N3MI-DG/sc-guides/A4T/README.md

# DragonBurner for StealthChanger

Goto [stealthchanger.com](https://www.stealthchanger.com/hardware/guides/toolheads/4_a4t/) for the build guide.

This collection is just for archive purposes.
Credits to Armchair-Heavy-Industries for the [A4T](https://github.com/Armchair-Heavy-Industries/A4T) and DraftShift Design for [StealthChanger](https://github.com/DraftShift/StealthChanger).
