N3MI-DG/sc-guides/Yavoth/README.md

# Yavoth HF for StealthChanger

Goto [stealthchanger.com](https://www.stealthchanger.com/hardware/guides/toolheads/3_yavoth/) for the build guide.

This collection is just for archive purposes.
Credits to chirpy2605 for the [Yavoth](https://github.com/chirpy2605/voron/tree/main/V0/Yavoth) and DraftShift Design for [StealthChanger](https://github.com/DraftShift/StealthChanger).
