N3MI-DG/sc-guides/DragonBurner/README.md

# DragonBurner for StealthChanger

Goto [stealthchanger.com](https://www.stealthchanger.com/hardware/guides/toolheads/2_dragonburner/) for the build guide.

This collection is just for archive purposes.
Credits to chirpy2605 for the [DragonBurner](https://github.com/chirpy2605/voron/tree/main/V0/Dragon_Burner) and DraftShift Design for [StealthChanger](https://github.com/DraftShift/StealthChanger).
