N3MI-DG/sc-guides/Anthead/images/nh36-revc-pinout-20250331.jpg

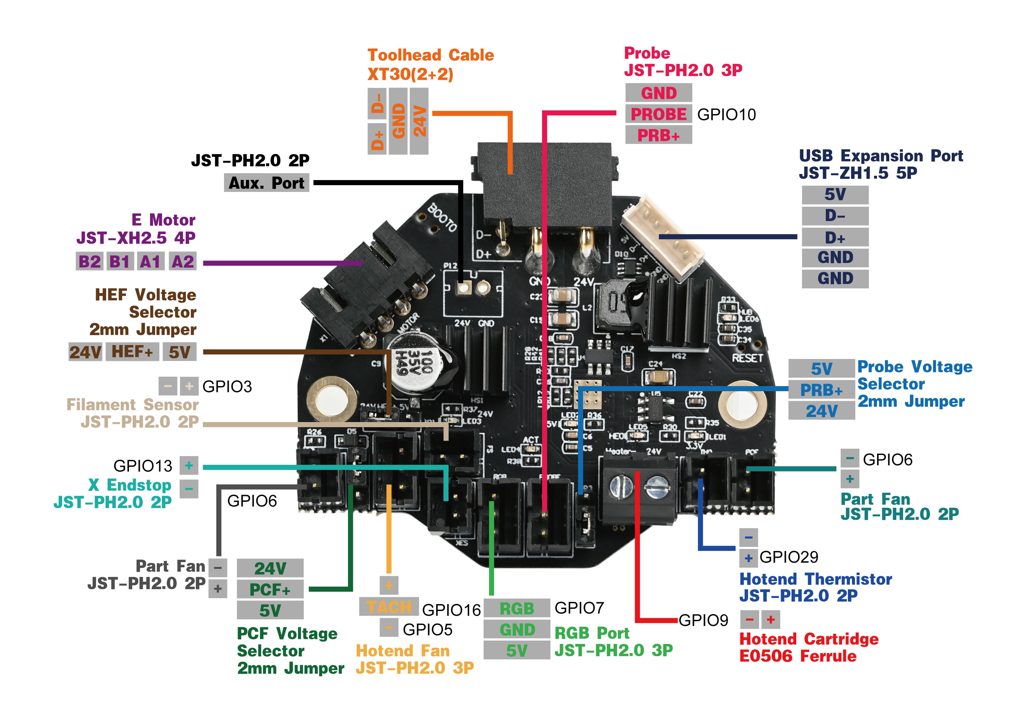
Anthead/images/nh36-revc-pinout-20250331.jpg
