N3MI-DG/sc-guides/Anthead/STL/SF O2 Main Body.stl

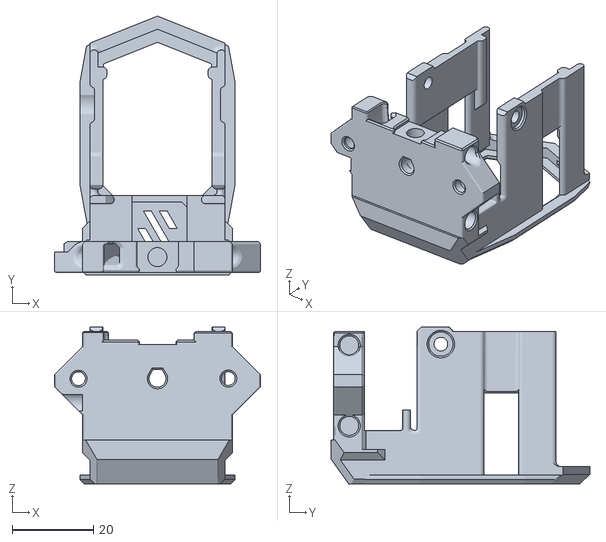
[picture p33: CAD file, 2025-06-15]
Anthead/STL/SF O2 Main Body.stl
50.8 x 63.8 x 38.6
