N3MI-DG/sc-guides/A4T/STL/A4T LED Carrier.stl

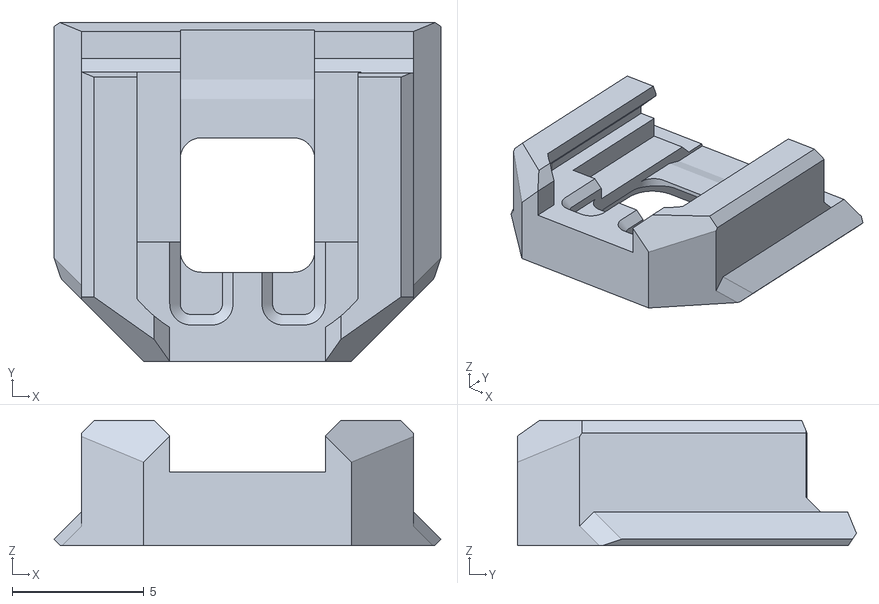
[picture p34: CAD file, 2026-03-08]
A4T/STL/A4T LED Carrier.stl
14.7 x 12.9 x 4.75
