N3MI-DG/sc-guides/Anthead/STL/[a] Revo HE Mount.stl

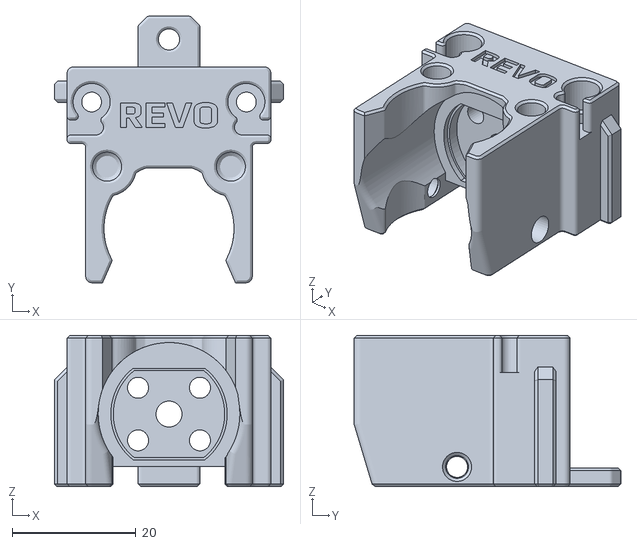
[picture p35: CAD file, 2026-01-17]
Anthead/STL/[a] Revo HE Mount.stl
37.0 x 43.1 x 24.4
