N3MI-DG/sc-guides/DragonBurner/STL/Solder Jig.stl

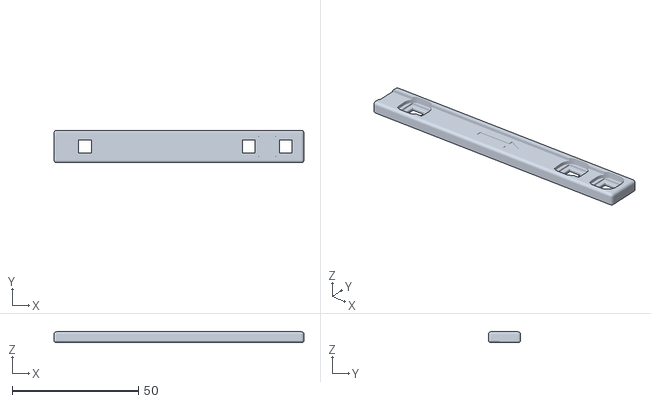
[picture p36: CAD file, 2026-01-14]
DragonBurner/STL/Solder Jig.stl
99.2 x 12.8 x 4.18
