N3MI-DG/sc-guides/Yavoth/STL/EBB Mount.stl

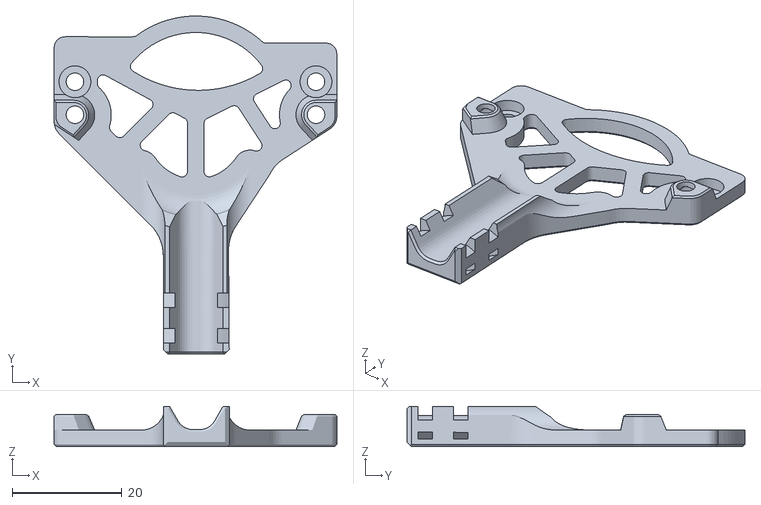
[picture p37: CAD file, 2025-12-29]
Yavoth/STL/EBB Mount.stl
51.4 x 61.5 x 7.30
