N3MI-DG/sc-guides/A4T/STL/A4T LED Filter[opaque].stl

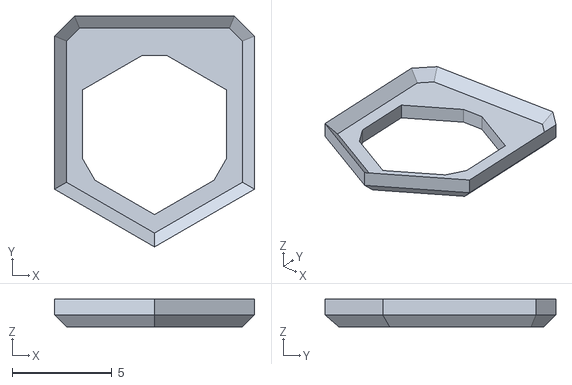
[picture p38: CAD file, 2026-03-08]
A4T/STL/A4T LED Filter[opaque].stl
10.0 x 11.5 x 1.40
