N3MI-DG/sc-guides/Anthead/STL/[c] Diffuser Voron.stl

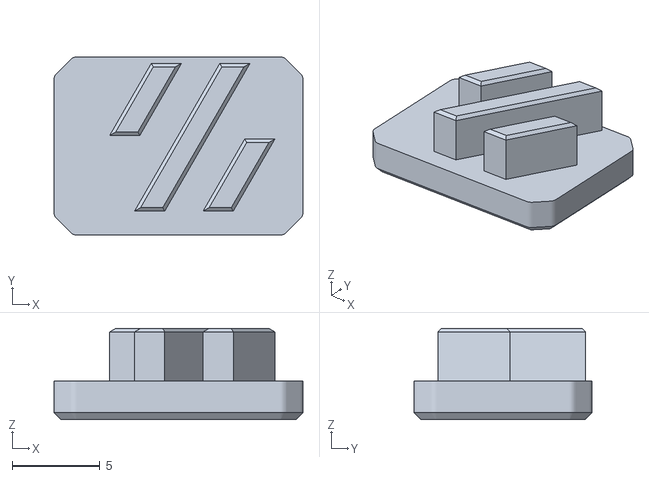
[picture p39: CAD file, 2025-06-15]
Anthead/STL/[c] Diffuser Voron.stl
14.2 x 10.1 x 5.20
