N3MI-DG/sc-guides/DragonBurner/STL/Neopixel Carrier.stl

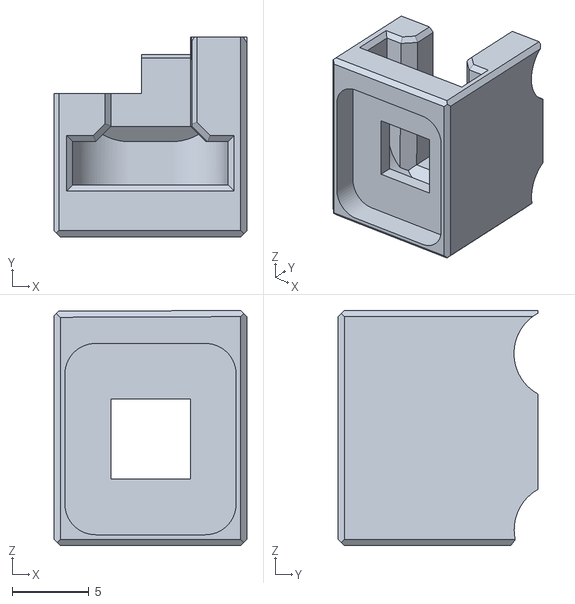
[picture p40: CAD file, 2025-12-28]
DragonBurner/STL/Neopixel Carrier.stl
12.5 x 13.0 x 15.3
