N3MI-DG/sc-guides/Yavoth/STL/Yavoth Backplate.stl

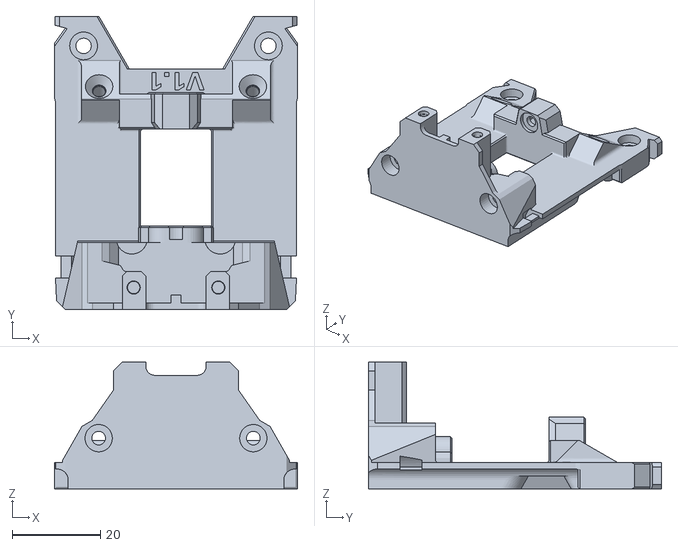
[picture p41: CAD file, 2025-12-29]
Yavoth/STL/Yavoth Backplate.stl
55.0 x 66.3 x 28.7
