N3MI-DG/sc-guides/A4T/STL/A4T - THB Mount - WWBMG.stl

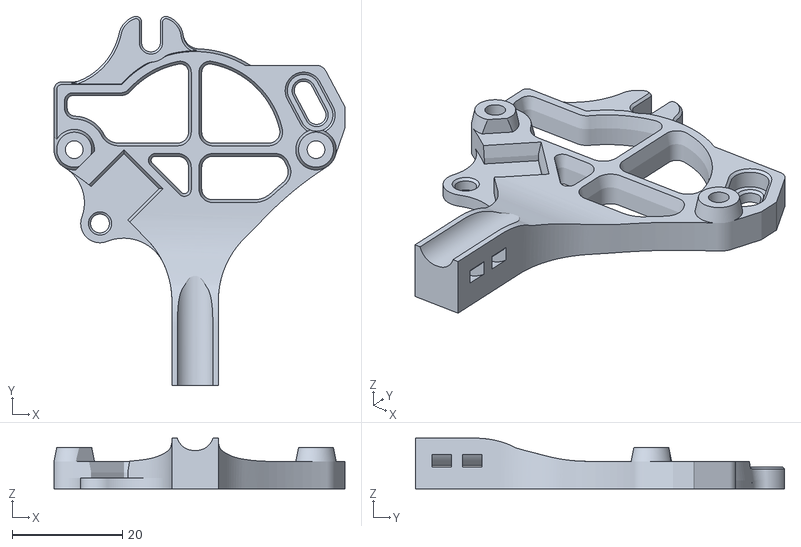
[picture p42: CAD file, 2026-03-08]
A4T/STL/A4T - THB Mount - WWBMG.stl
52.8 x 67.0 x 9.20
