N3MI-DG/sc-guides/Anthead/STL/[a] Right Duct Standard.stl

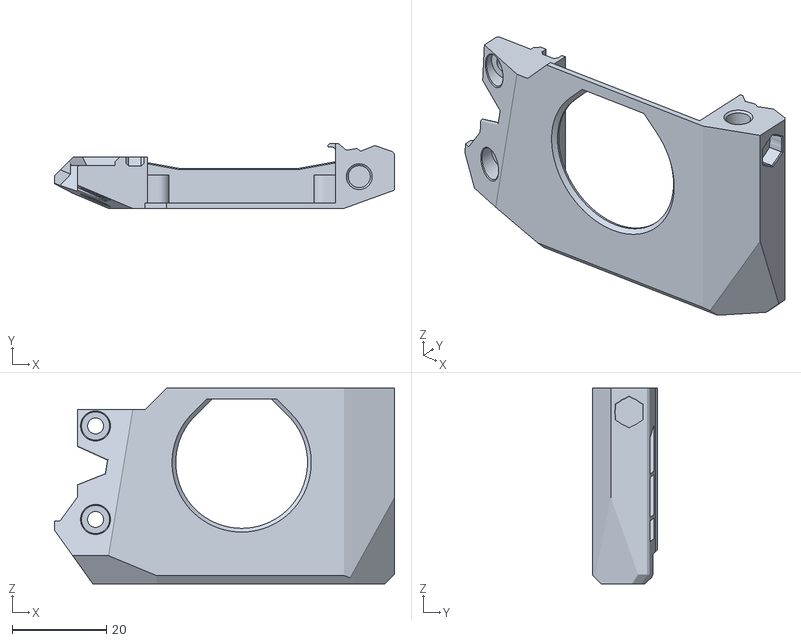
[picture p43: CAD file, 2025-06-15]
Anthead/STL/[a] Right Duct Standard.stl
72.3 x 13.8 x 41.6
