N3MI-DG/sc-guides/DragonBurner/STL/EBB Mount.stl

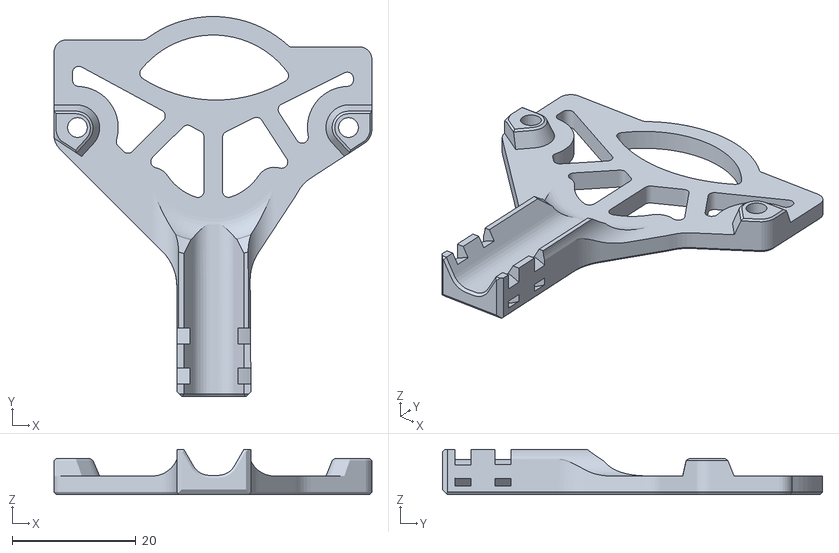
[picture p44: CAD file, 2025-12-28]
DragonBurner/STL/EBB Mount.stl
51.4 x 61.5 x 7.30
