N3MI-DG/sc-guides/Yavoth/STL/LED Holder.stl

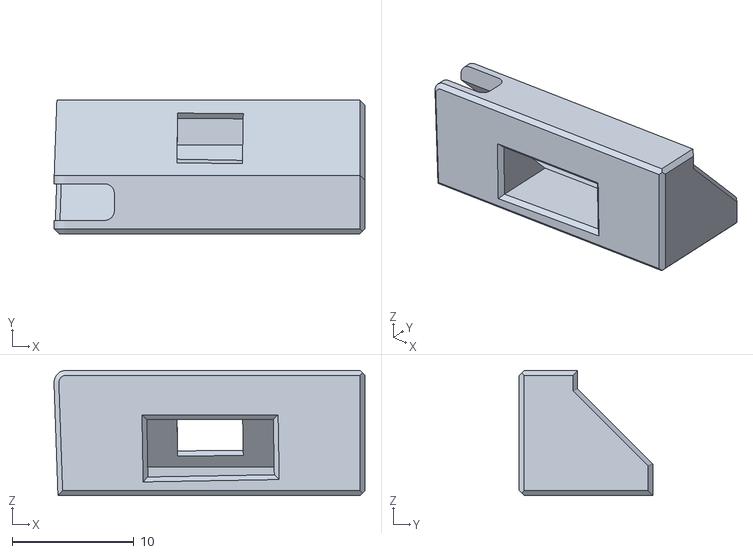
[picture p45: CAD file, 2025-12-29]
Yavoth/STL/LED Holder.stl
25.6 x 11.0 x 10.3
