N3MI-DG/sc-guides/A4T/STL/A4T Backflow Inhibitor install spacer tool.stl

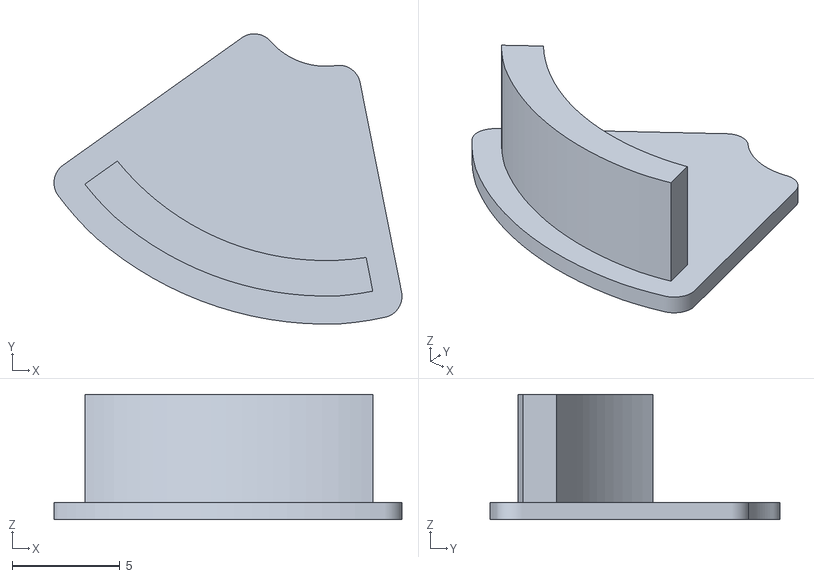
[picture p46: CAD file, 2026-03-08]
A4T/STL/A4T Backflow Inhibitor install spacer tool.stl
16.1 x 13.4 x 5.80
