N3MI-DG/sc-guides/DragonBurner/STL/Sherpa Mini Mount.stl

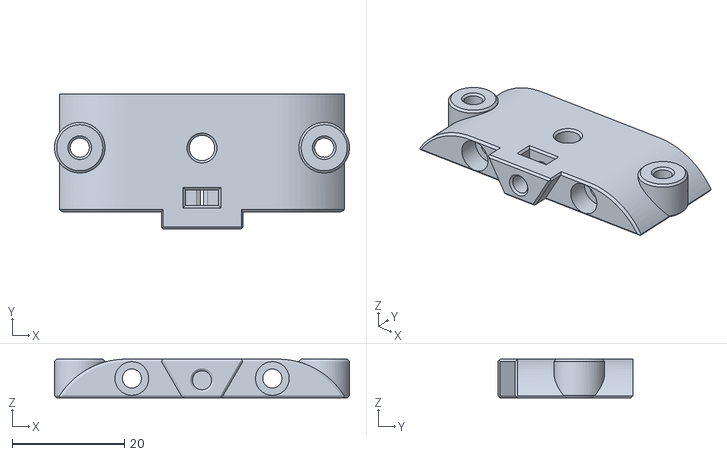
[picture p47: CAD file, 2025-12-28]
DragonBurner/STL/Sherpa Mini Mount.stl
52.5 x 24.1 x 6.90
