N3MI-DG/sc-guides/Yavoth/STL/Yavoth Cowl.stl

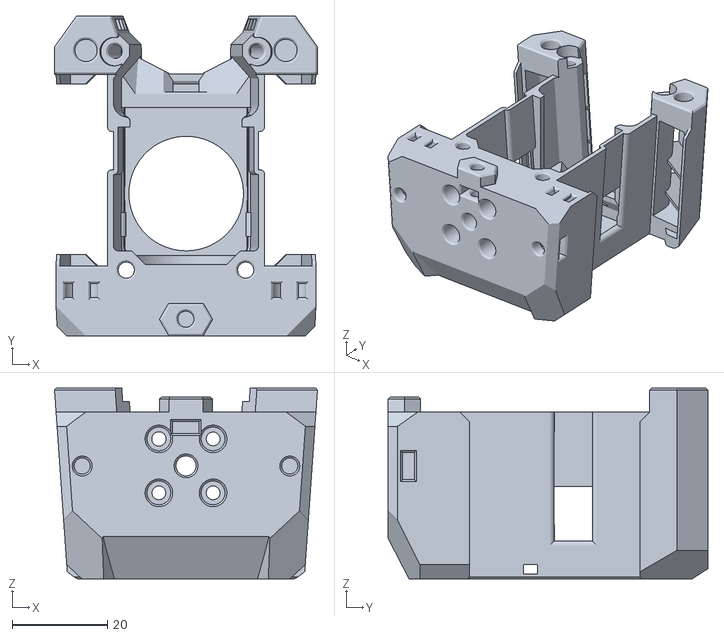
[picture p48: CAD file, 2025-12-29]
Yavoth/STL/Yavoth Cowl.stl
55.1 x 67.0 x 40.0
