N3MI-DG/sc-guides/A4T/STL/A4T HE Fan Duct - Rapido.stl

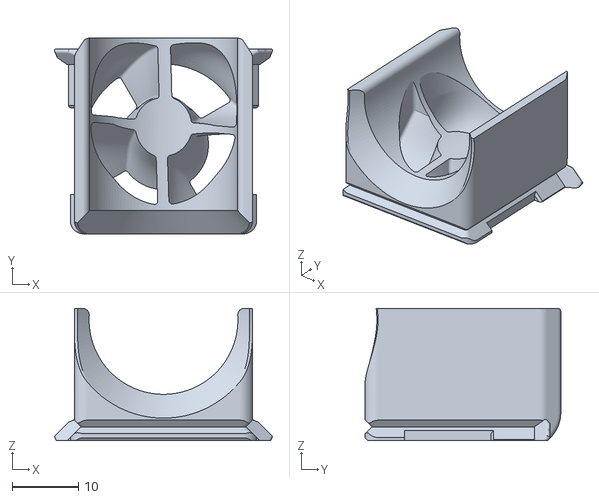
[picture p49: CAD file, 2026-03-08]
A4T/STL/A4T HE Fan Duct - Rapido.stl
33.0 x 29.6 x 20.0
