N3MI-DG/sc-guides/Anthead/STL/[o] Light Shield Voron.stl

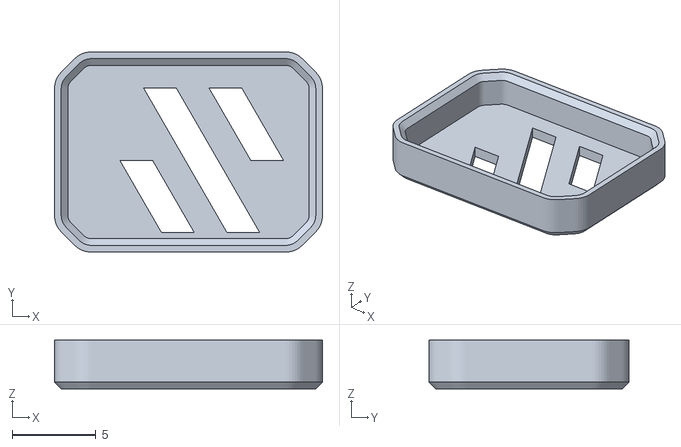
[picture p50: CAD file, 2025-06-15]
Anthead/STL/[o] Light Shield Voron.stl
16.0 x 11.9 x 2.90
