N3MI-DG/sc-guides/DragonBurner/STL/DragonBurner Spacer.stl

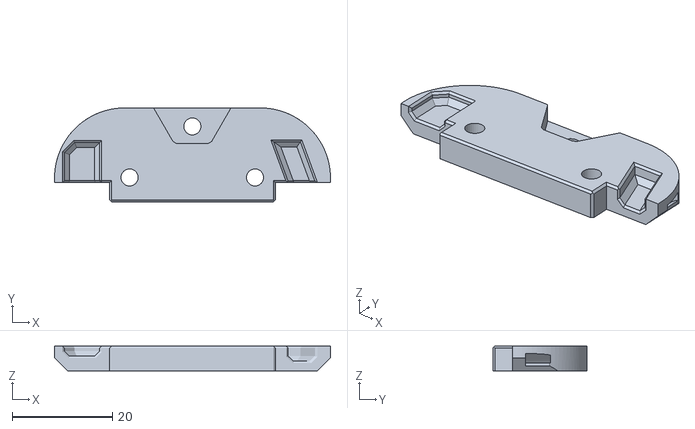
[picture p51: CAD file, 2025-12-28]
DragonBurner/STL/DragonBurner Spacer.stl
55.0 x 18.8 x 4.97
