N3MI-DG/sc-guides/Yavoth/STL/Spacer.stl

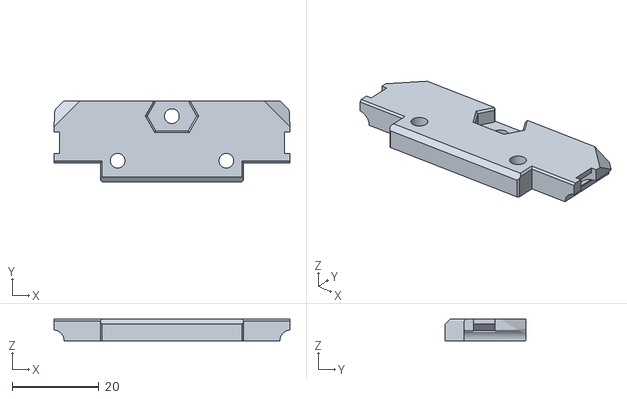
[picture p52: CAD file, 2025-12-29]
Yavoth/STL/Spacer.stl
54.4 x 18.7 x 4.97
