N3MI-DG/sc-guides/A4T/STL/A4T LED Diffuser[translucent].stl

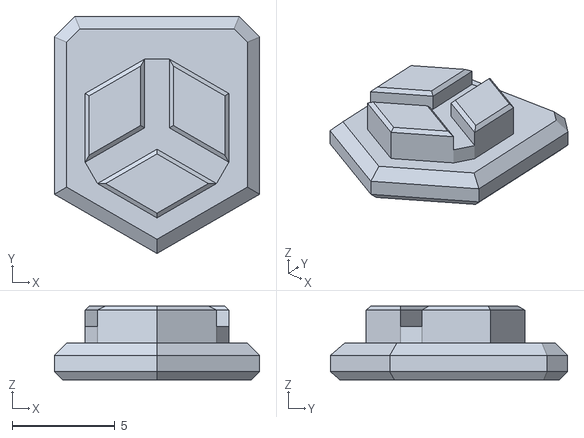
[picture p53: CAD file, 2026-03-08]
A4T/STL/A4T LED Diffuser[translucent].stl
10.0 x 11.5 x 3.60
