N3MI-DG/sc-guides/Anthead/STL/Anthead_Spacer.stl

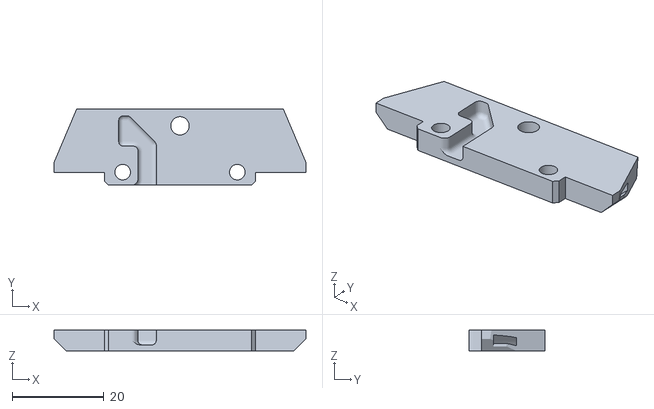
[picture p54: CAD file, 2025-06-15]
Anthead/STL/Anthead_Spacer.stl
55.0 x 16.6 x 4.56
