N3MI-DG/sc-guides/DragonBurner/STL/Cowl.stl

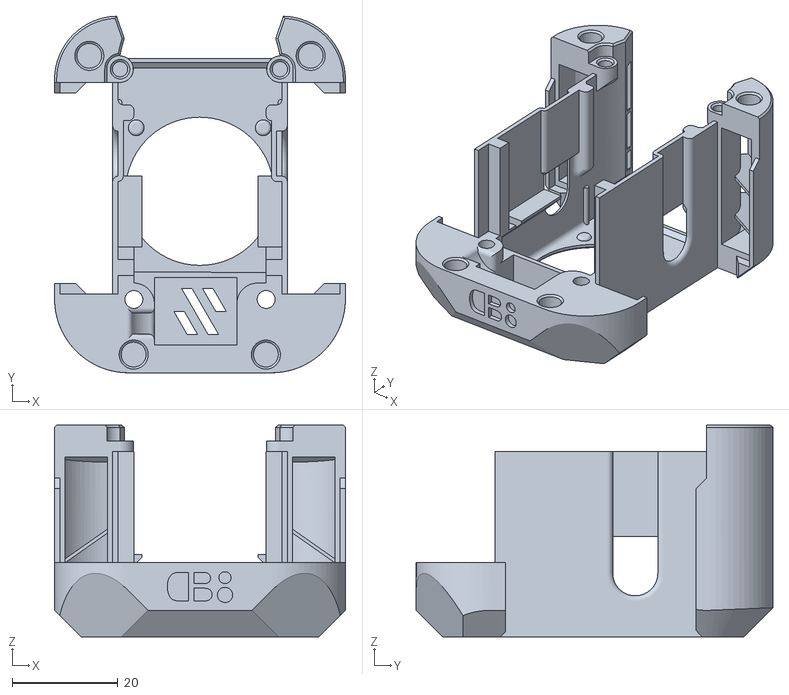
[picture p55: CAD file, 2025-12-28]
DragonBurner/STL/Cowl.stl
55.0 x 67.4 x 40.0
