N3MI-DG/sc-guides/A4T/STL/A4T Backflow Inhibitor [x2].stl

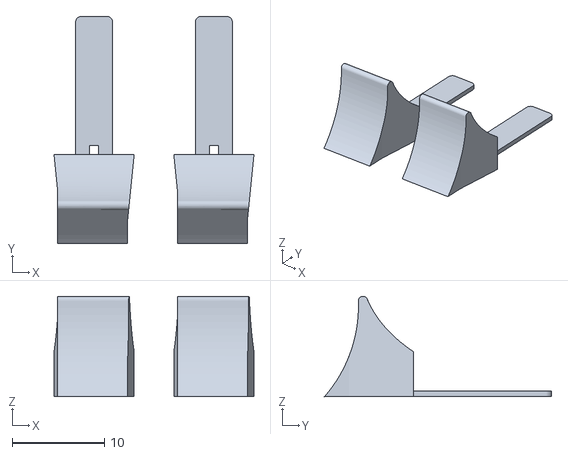
[picture p56: CAD file, 2026-03-08]
A4T/STL/A4T Backflow Inhibitor [x2].stl
21.7 x 24.6 x 10.9
