N3MI-DG/sc-guides/Anthead/STL/[o] Logo LED Carrier.stl

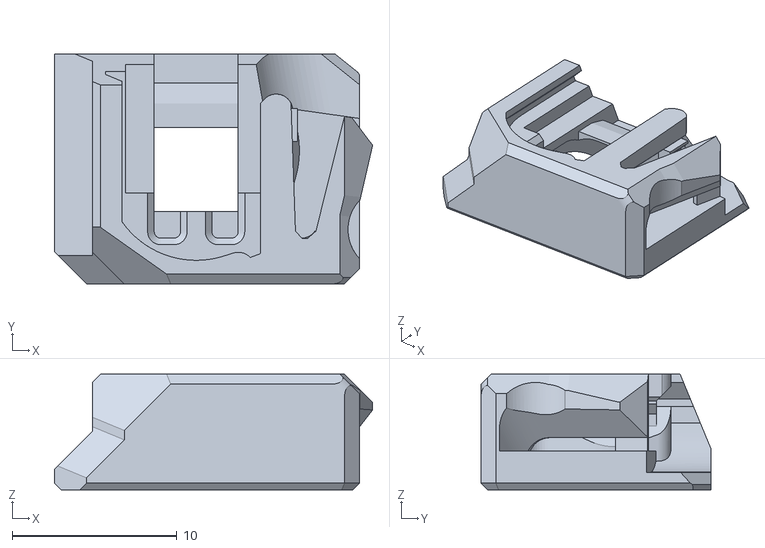
[picture p57: CAD file, 2025-06-15]
Anthead/STL/[o] Logo LED Carrier.stl
19.3 x 14.0 x 7.01
