N3MI-DG/sc-guides/DragonBurner/STL/Backplate.stl

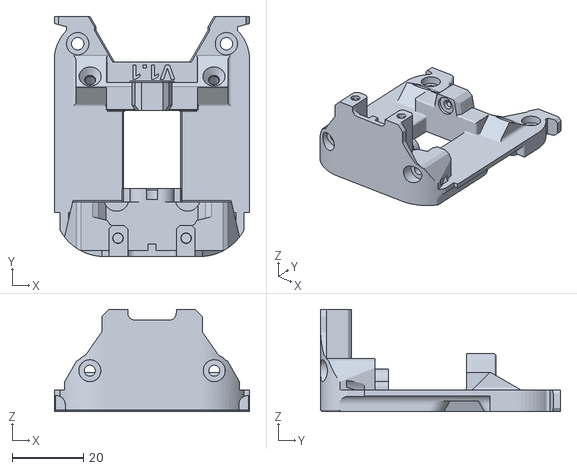
[picture p58: CAD file, 2025-12-28]
DragonBurner/STL/Backplate.stl
55.0 x 67.5 x 28.7
