N3MI-DG/sc-guides/A4T/STL/A4T Cowling - Dragon-Rapido UHF [xol-carriage].stl

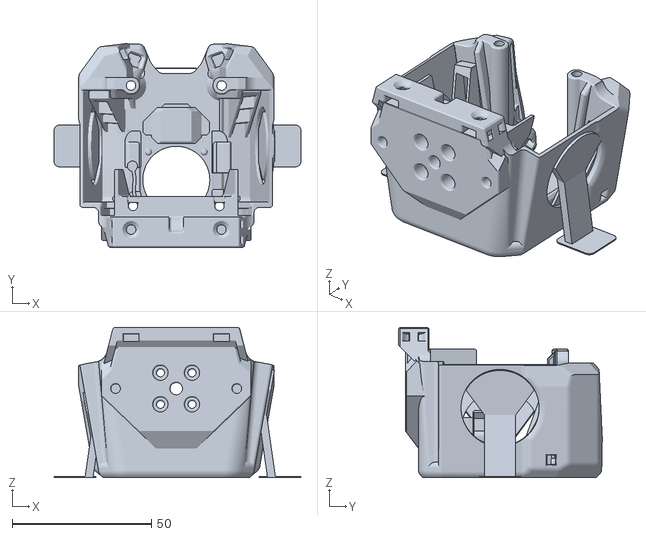
[picture p59: CAD file, 2026-03-08]
A4T/STL/A4T Cowling - Dragon-Rapido UHF [xol-carriage].stl
88.6 x 73.0 x 53.8
