N3MI-DG/sc-guides/DragonBurner/STL/Diffuser.stl

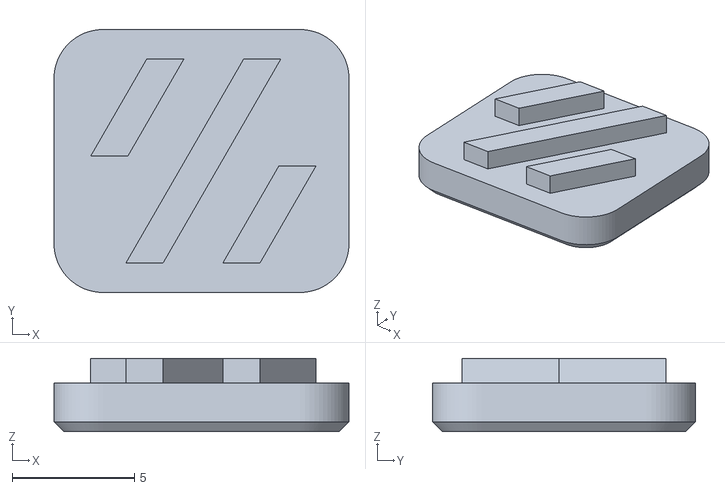
[picture p60: CAD file, 2025-12-28]
DragonBurner/STL/Diffuser.stl
12.1 x 10.7 x 3.00
