N3MI-DG/sc-guides/A4T/STL/A4T Stealthchanger Backplate.stl

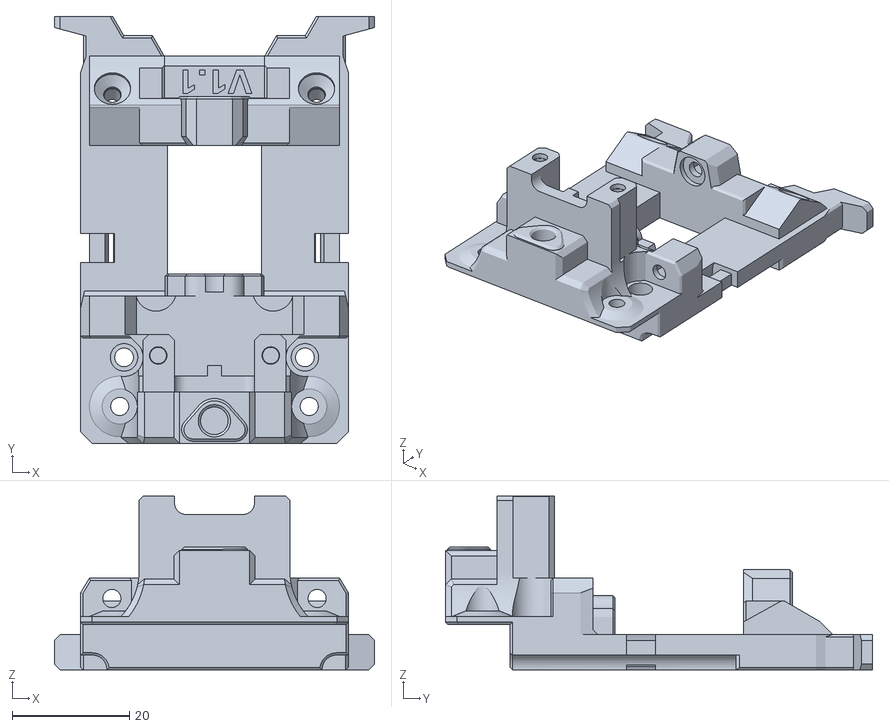
[picture p61: CAD file, 2026-03-08]
A4T/STL/A4T Stealthchanger Backplate.stl
54.6 x 72.8 x 29.6
