N3MI-DG/sc-guides/Anthead/STL/PCBMount.stl

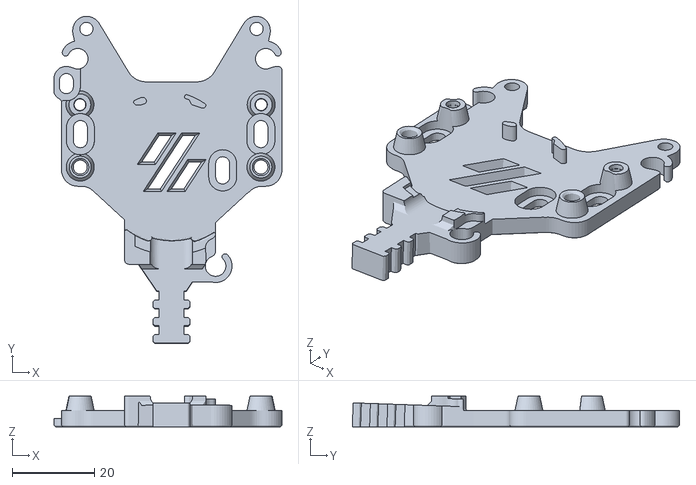
[picture p62: CAD file, 2025-06-15]
Anthead/STL/PCBMount.stl
55.3 x 79.5 x 7.50
