N3MI-DG/sc-guides/DragonBurner/STL/2510 Spacer.stl

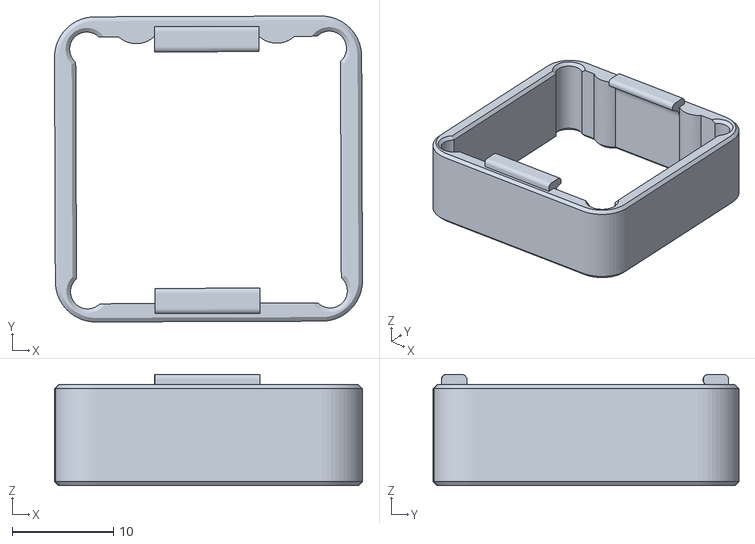
[picture p63: CAD file, 2025-12-28]
DragonBurner/STL/2510 Spacer.stl
30.5 x 30.3 x 11.0
