N3MI-DG/sc-guides/Anthead/STL/[a] Nozzle LED Restraint.stl

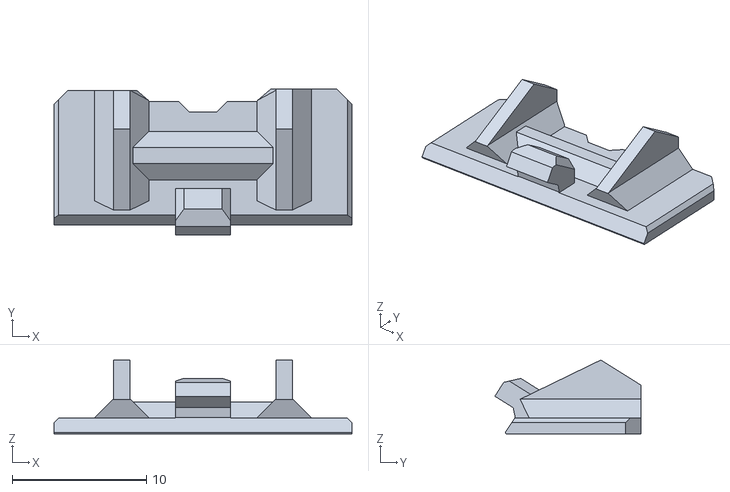
[picture p64: CAD file, 2025-06-15]
Anthead/STL/[a] Nozzle LED Restraint.stl
22.2 x 10.9 x 5.51
