N3MI-DG/sc-guides/DragonBurner/STL/NeoPixel Mount.stl

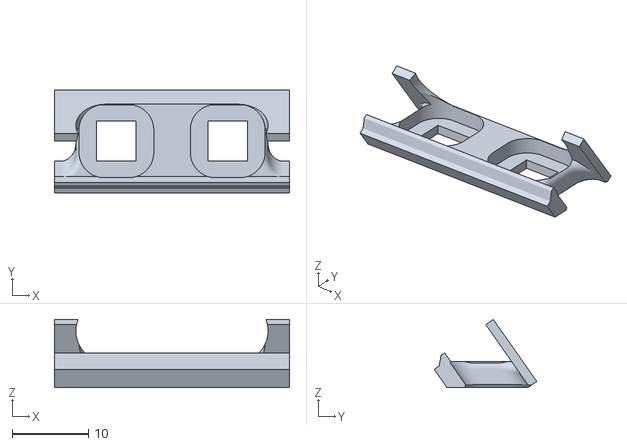
[picture p65: CAD file, 2025-12-28]
DragonBurner/STL/NeoPixel Mount.stl
30.8 x 13.4 x 8.93
