N3MI-DG/sc-guides/Anthead/STL/[a] Open Grill.stl

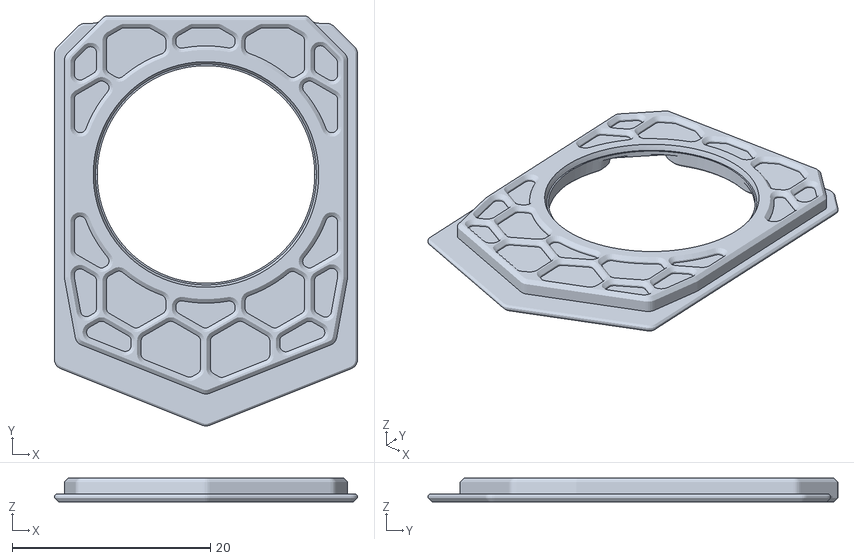
[picture p66: CAD file, 2025-06-15]
Anthead/STL/[a] Open Grill.stl
30.6 x 41.4 x 2.40
