N3MI-DG/sc-guides/DragonBurner/STL/Bambu Mount.stl

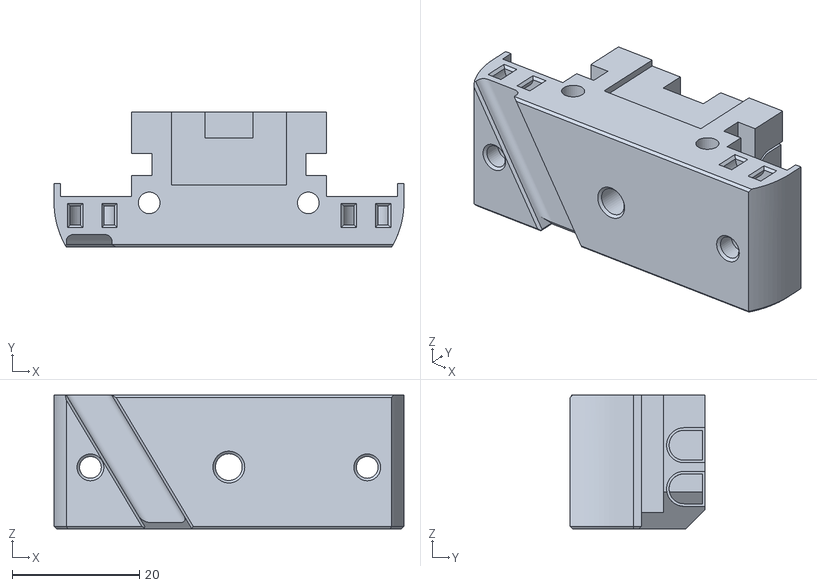
[picture p67: CAD file, 2025-12-28]
DragonBurner/STL/Bambu Mount.stl
55.0 x 21.3 x 21.0
