N3MI-DG/sc-guides/Anthead/STL/[a] Nozzle LED Carrier.stl

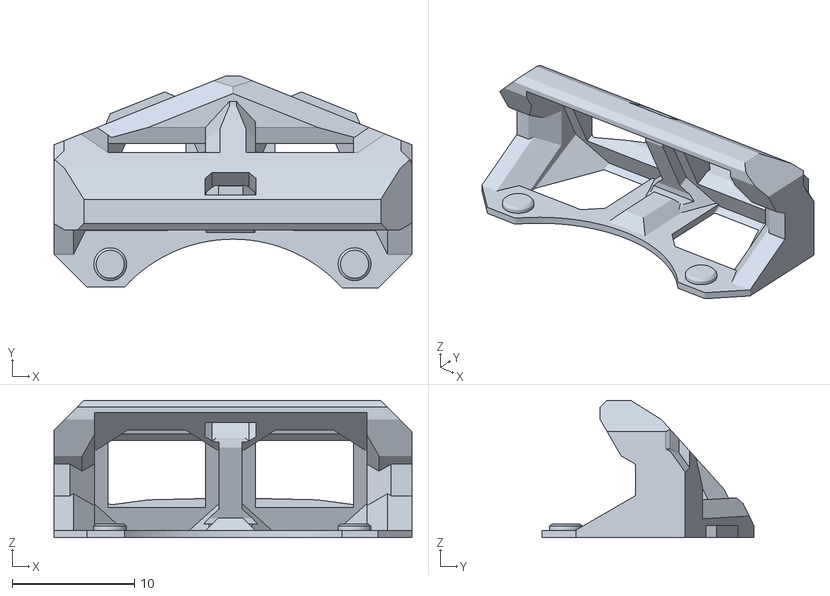
[picture p68: CAD file, 2025-06-15]
Anthead/STL/[a] Nozzle LED Carrier.stl
29.3 x 17.3 x 11.2
