N3MI-DG/sc-guides/Anthead/STL/[a] Nitehawk36 Cover.stl

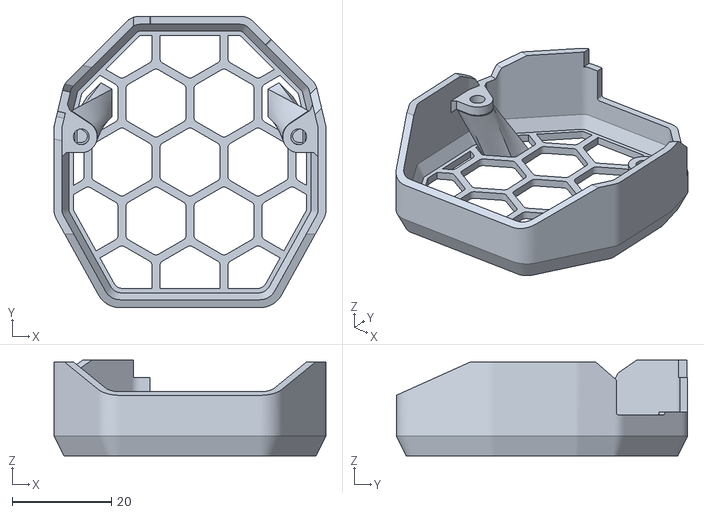
[picture p69: CAD file, 2025-06-15]
Anthead/STL/[a] Nitehawk36 Cover.stl
54.8 x 58.7 x 19.3
