N3MI-DG/sc-guides/Anthead/STL/Spacers.stl

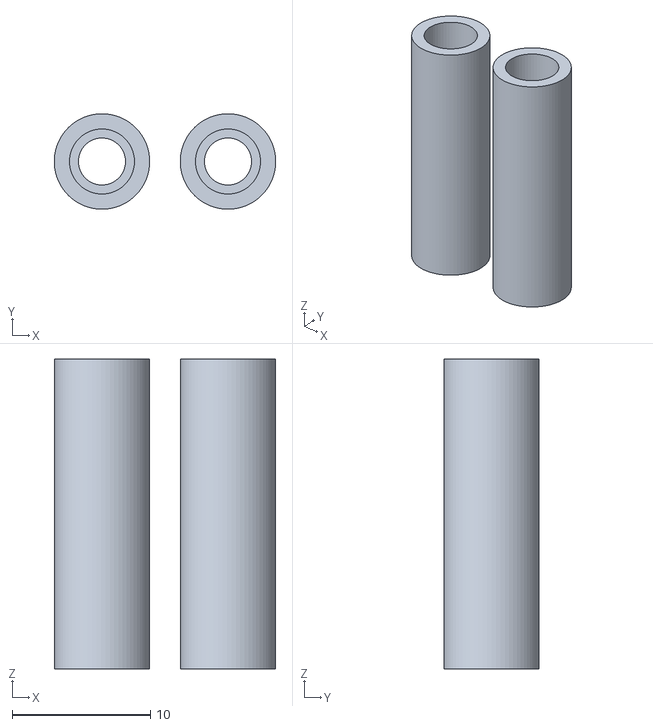
[picture p70: CAD file, 2025-06-15]
Anthead/STL/Spacers.stl
16.0 x 6.90 x 22.4
