N3MI-DG/sc-guides/Anthead/STL/[TPU] NH36Sock.stl

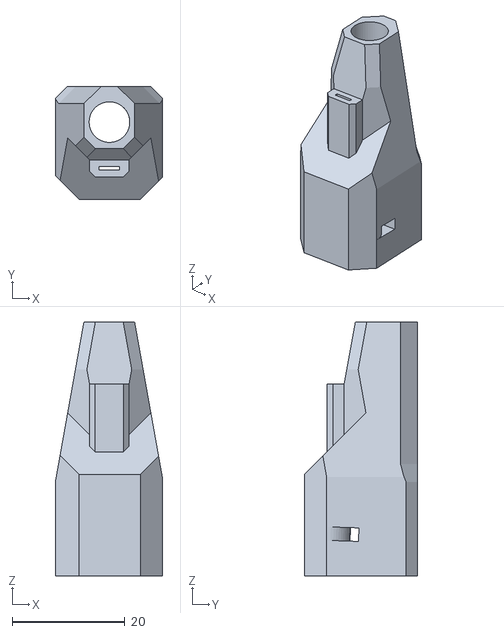
[picture p71: CAD file, 2025-06-15]
Anthead/STL/[TPU] NH36Sock.stl
18.9 x 20.0 x 45.0
