N3MI-DG/sc-guides/(list of files, cad)

Other CAD files:
Anthead/STL/Anthead Back Plate.stl
Anthead/STL/[a] Left Duct Standard.stl
