N3MI-DG/sc-guides/(commit log)

2025-06-15 Upload print files and clean cad
    [Anthead Back Plate.stl, Anthead_Spacer.stl, PCBMount.stl, SF O2 Main Body.stl, Spacers.stl, [TPU] NH36Sock.stl, [a] Left Duct Standard.stl, [a] Nitehawk36 Cover.stl]
2025-06-15 Move the guide CAD to the CAD folder
2025-08-22 Complete Stealthchanger CAD
2025-12-28 Add DragonBurner.
    [2510 Spacer.stl, Backplate.stl, Bambu Mount.stl, Cowl.stl, Diffuser.stl, DragonBurner Spacer.stl, EBB Mount.stl, NeoPixel Mount.stl]
2025-12-29 Add Yavoth.
    [EBB Mount.stl, LED Holder.stl, Spacer.stl, Yavoth Backplate.stl, Yavoth Cowl.stl]
2026-01-14 Add 5mm to solder jig
    [Solder Jig.stl]
2026-01-17 Fix HE mount orientation
    [[a] Revo HE Mount.stl]
2026-03-08 Add A4T files
    [A4T - THB Mount - WWBMG.stl, A4T Backflow Inhibitor [x2].stl, A4T Backflow Inhibitor install spacer tool.stl, A4T Cowling - Dragon-Rapido UHF [xol-carriage].stl, A4T HE Fan Duct - Rapido.stl, A4T LED Carrier.stl, A4T LED Diffuser[translucent].stl, A4T LED Filter[opaque].stl]
